spareknobs/Eris/pcb/Eris_v_1_1_pcb_render_front.png

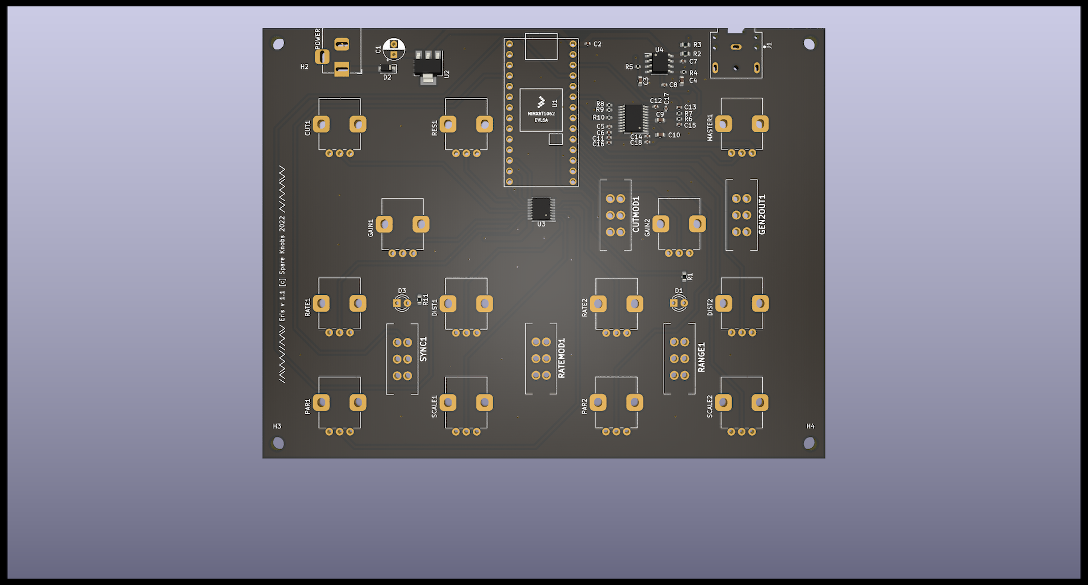
pcb/Eris_v_1_1_pcb_render_front.png
