spareknobs/Eris/Eris_v_1_1_Schematic.pdf

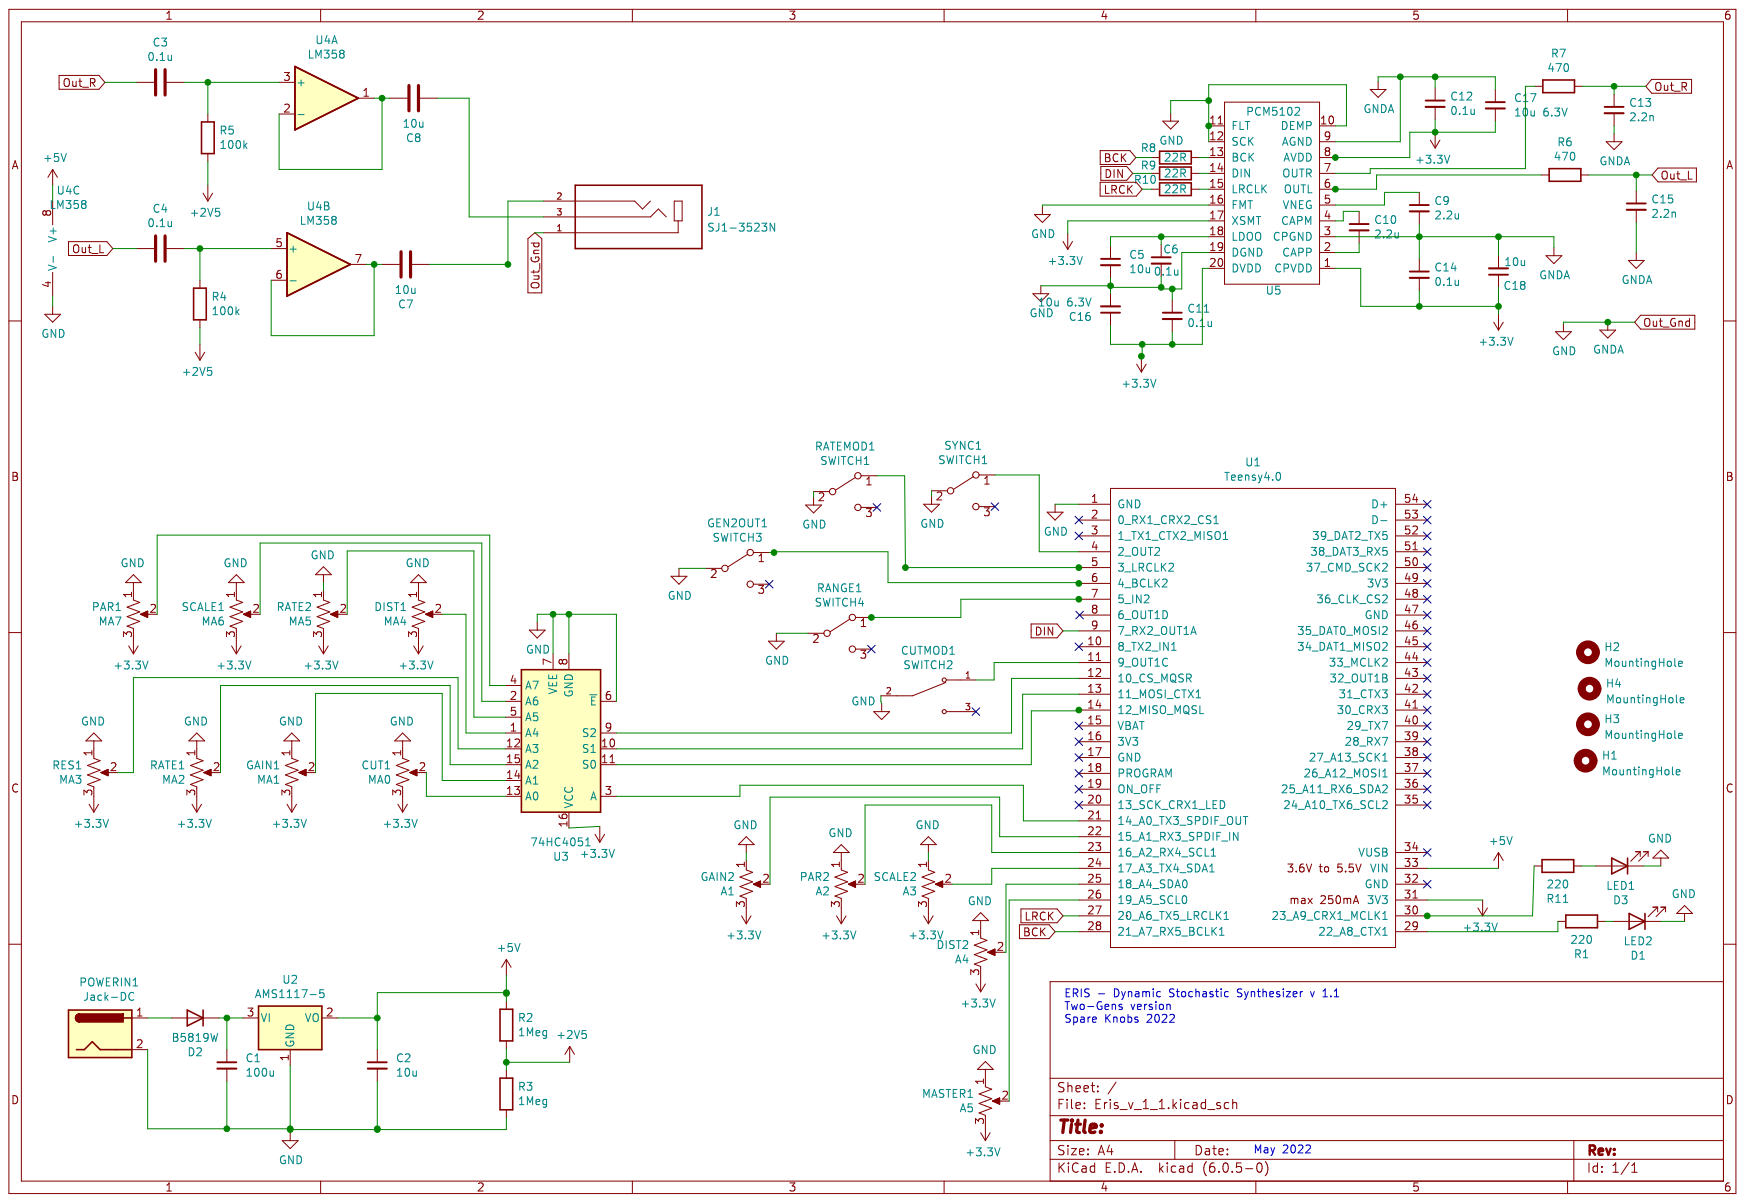
[picture p3: page 1]
