spareknobs/Eris/src/Eris.cpp

/*
   Eris - Dynamic Stochastic Synthesizer
   Spare Knobs 2020-2024

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
   You should have received a copy of the GNU General Public License
   along with this program; if not, write to the Free Software
   Foundation, Inc., 51 Franklin Street, Fifth Floor, Boston, MA 02110-1301  USA
*/

#include <Arduino.h>
#include "Eris.h"

Eris::Eris() : AudioStream( 0, NULL ){
   mGen1.SetSamplerate(SR_DEF);
   mGen2.SetFreqRange(0);
   mGen1.SetFreqNorm(0.25f);
   mGen1.SetScale(0.5f);
   mGen1.SetParam(0.5f);
   mGen2.SetSamplerate(SR_DEF);
   mGen2.SetFreqRange(0);
   mGen2.SetFreqNorm(0.5f);
   mGen2.SetParam(1.f);
   mGen2.SetScale(1.f);
   mGen2.SetDist(0.f);
   mVcf.SetCutoff(5000.f);
   mVcf.SetResonance(1.f);
   mVcf.octaveControl(0.f);
   mAREnv.SetGain(1.f);
   mAREnv.SetAttackMs(100.f);
   mAREnv.SetReleaseMs(200.f);
   msine.set_freq(400);
}

 void Eris::update(void){

   float blockGen1[AUDIO_BLOCK_SAMPLES];
   int16_t blockGen1t[AUDIO_BLOCK_SAMPLES];
   float blockGen2[AUDIO_BLOCK_SAMPLES];
   int16_t blockGen2t[AUDIO_BLOCK_SAMPLES];
   float blockLfo[AUDIO_BLOCK_SAMPLES];
   int16_t blockLfot[AUDIO_BLOCK_SAMPLES];

   audio_block_t *blockout;
   blockout = allocate();
   if (!blockout) return; 

   memset(blockGen1, 0, AUDIO_BLOCK_SAMPLES * sizeof(float));
   memset(blockGen2, 0, AUDIO_BLOCK_SAMPLES * sizeof(float));
   memset(blockGen1t, 0, AUDIO_BLOCK_SAMPLES * sizeof(int16_t));
   memset(blockGen2t, 0, AUDIO_BLOCK_SAMPLES * sizeof(int16_t));
   memset(blockLfot, 0, AUDIO_BLOCK_SAMPLES * sizeof(int16_t));
   memset(blockLfo, 0, AUDIO_BLOCK_SAMPLES * sizeof(float));

   // test
   //msine.Process(blockGen1, AUDIO_BLOCK_SAMPLES);

   mGen2.Process( blockGen2, blockGen2, 0.f, AUDIO_BLOCK_SAMPLES );   
         
   f2fix(blockGen2, blockGen2t, AUDIO_BLOCK_SAMPLES);

   // Update Gen2 Gain
   int16_t *op2 = (int16_t*)blockGen2t; 
   const int16_t* oend2 = (int16_t*)(blockGen2t + AUDIO_BLOCK_SAMPLES);
   do {
         if ( mGen2Gain < mGen2Gain_req ){
            mGen2Gain += GAIN_RAMP_STEP;
            if ( mGen2Gain > mGen2Gain_req )  mGen2Gain = mGen2Gain_req; 
         }
         else if ( mGen2Gain > mGen2Gain_req ){
            mGen2Gain -= GAIN_RAMP_STEP;
            if ( mGen2Gain < mGen2Gain_req )  mGen2Gain = mGen2Gain_req; 
         }
        int16_t tmp = *op2;
        *op2++ = ( mGen2Gain * tmp ) >> 16;
   } while (op2 < oend2);

   // Gen2 --> Lfo
   for ( int n=0; n < AUDIO_BLOCK_SAMPLES; ++n ) {
      float val =  (float)blockGen2t[n] * Q_DIV_16;
      //val = 0.5 * val + 0.5; 
      blockLfo[n] = val * 3.0; // scale up 
   }

   // Modulate Gen1 Rate with Lfo
   float vRateMod = (float)mRateMod;
   mGen1.Process( blockGen1, blockLfo, vRateMod, AUDIO_BLOCK_SAMPLES );
   f2fix(blockGen1, blockGen1t, AUDIO_BLOCK_SAMPLES);

   // Gen1 Gain @ sr
   int16_t *op1 = (int16_t*)blockGen1t; 
   const int16_t* oend1 = (int16_t*)(blockGen1t + AUDIO_BLOCK_SAMPLES);
   do {
         if ( mGen1Gain < mGen1Gain_req ){
            mGen1Gain += GAIN_RAMP_STEP;
            if ( mGen1Gain > mGen1Gain_req )  mGen1Gain = mGen1Gain_req; 
         }
         else if ( mGen1Gain > mGen1Gain_req ){
            mGen1Gain -= GAIN_RAMP_STEP;
            if ( mGen1Gain < mGen1Gain_req )  mGen1Gain = mGen1Gain_req; 
         }
        int16_t tmp = *op1;
        *op1++ = ( mGen1Gain * tmp ) >> 16;
   } while (op1 < oend1);
   
   // save a value for controlling LEDs
   mLastGen1Val = blockGen1[0] * blockGen1[0];
   mLastGen2Val = blockGen2[0] * blockGen2[0];
   
   if (mGen2ToOut){
      for ( int n=0; n < AUDIO_BLOCK_SAMPLES; ++n ) {
         int16_t vmix = signed_add_16_and_16(blockGen1t[n],blockGen2t[n]);
         blockGen1t[n] = vmix;
      }
   }

   // temp
   f2fix(blockLfo, blockLfot, AUDIO_BLOCK_SAMPLES);

   // Process Filter 
   mVcf.Process( blockGen1t, blockout->data, blockLfot, AUDIO_BLOCK_SAMPLES );

   // Process AR
   mAREnv.Process( blockout, AUDIO_BLOCK_SAMPLES );
   if (mAREnv.Done()) mMidiFreq_req=0;

   // (double mono for now)
   transmit( blockout,0 );
   transmit( blockout,1 );   
   release( blockout );
 }

void Eris::TriggerMidiNote( byte acNote, byte acVel ){
      __disable_irq();
      mMidiFreq_req = gcNoteFreqs[acNote];
      mGen1.SetFreq(mMidiFreq_req);
      
      // control gen2 only if @audiorate
      if ( mGen2Range==0 ){
         int ind = (int)round( mGen2Rate_req * (NPARTIALRATIOS-1) );
         float vpartialRatio = gcPartialsRatios[ind];
         float vval = Clip( vpartialRatio * mGen1.Freq(), FREQ_MIN, FREQ_MAX );
         mGen2.SetFreq( vval );
      }  
      mAREnv.SetGain( (float)acVel * DIV127 );
      mAREnv.TriggerAttack();
      __enable_irq();
    }

void Eris::TriggerRelease(){
      __disable_irq();
      mAREnv.TriggerRelease();
      __enable_irq();
   }

void Eris::SetGen1Rate( float acValue ){
   __disable_irq();
   // if midi note active, bypass
   if (mMidiFreq_req == 0){
      mGen1Rate_req = acValue;
      mGen1.SetFreqNorm(mGen1Rate_req);
   }
   // if midi note active and gen2 is @ audiorate, or sync is on, gen2 rate controls the harmonic #
   if ( mSyncGens==true || ( mMidiFreq_req>0 && mGen2Range==0 )){
      int ind = (int)round( mGen2Rate_req * (NPARTIALRATIOS-1) );
      float vpartialRatio = gcPartialsRatios[ind];
      float vval = Clip( vpartialRatio * mGen1.Freq(), FREQ_MIN, FREQ_MAX );
      mGen2.SetFreq( vval );
   }      
   __enable_irq();
}

void Eris::SetGen2Rate( float acValue ){      
   __disable_irq();
   mGen2Rate_req = acValue;
   // if midi note active and gen2 is @ audiorate, or sync is on, gen2 rate controls the harmonic #
   if ( mSyncGens==true || ( mMidiFreq_req>0 && mGen2Range==0 )){
      int ind = (int)round( mGen2Rate_req * (NPARTIALRATIOS-1) );
      float vpartialRatio = gcPartialsRatios[ind];
      float vval = Clip( vpartialRatio * mGen1.Freq(), FREQ_MIN, FREQ_MAX );
      mGen2.SetFreq( vval );
   }
   else{
      mGen2.SetFreqNorm( mGen2Rate_req );
   }
   __enable_irq();
}
