spareknobs/Eris/include/VCFixed.h

/*
   Eris - Dynamic Stochastic Synthesizer
   Spare Knobs 2020-2024

  State Variable Filter (Chamberlin) with 2X oversampling

  Adapted from the implementation by Paul Stoffregen, see:
  https://github.com/PaulStoffregen/Audio
 
  */

/* Audio Library for Teensy 3.X
 * Copyright (c) 2014, Paul Stoffregen, paul@pjrc.com
 *
 * Development of this audio library was funded by PJRC.COM, LLC by sales of
 * Teensy and Audio Adaptor boards.  Please support PJRC's efforts to develop
 * open source software by purchasing Teensy or other PJRC products.
 *
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
 * THE SOFTWARE IS PROVIDED "AS IS", WITHOUT WARRANTY OF ANY KIND, EXPRESS OR
 * IMPLIED, INCLUDING BUT NOT LIMITED TO THE WARRANTIES OF MERCHANTABILITY,
 * FITNESS FOR A PARTICULAR PURPOSE AND NONINFRINGEMENT. IN NO EVENT SHALL THE
 * AUTHORS OR COPYRIGHT HOLDERS BE LIABLE FOR ANY CLAIM, DAMAGES OR OTHER
 * LIABILITY, WHETHER IN AN ACTION OF CONTRACT, TORT OR OTHERWISE, ARISING FROM,
 * OUT OF OR IN CONNECTION WITH THE SOFTWARE OR THE USE OR OTHER DEALINGS IN
 * THE SOFTWARE.
 */

#pragma once

#include <Arduino.h>    
#include "AudioStream.h"

class VCFixed
{
public:
	VCFixed() {
		SetCutoff(1000);
		octaveControl(1.0); // default values
		SetResonance(0.707);
		state_inputprev = 0;
		state_lowpass = 0;
		state_bandpass = 0;
	}

    void Process(const int16_t *in,  int16_t *out, const int16_t *ctl,  const int acsamples );
	
	void SetCutoff(float freq) {
		if (freq < 20.0f) freq = 20.0f;
		else if (freq > AUDIO_SAMPLE_RATE_EXACT/2.5f) freq = AUDIO_SAMPLE_RATE_EXACT/2.5f;
		setting_fcenter = (freq * (3.141592654f/(AUDIO_SAMPLE_RATE_EXACT*2.0f)))
			* 2147483647.0f;
		// TODO: should we use an approximation when freq is not a const,
		// so the sinf() function isn't linked?
		setting_fmult = sinf(freq * (3.141592654f/(AUDIO_SAMPLE_RATE_EXACT*2.0f)))
			* 2147483647.0f;
	}
	void SetResonance(float q) {
		if (q < 0.7f) q = 0.7f;
		else if (q > 5.0f) q = 5.0f;
		// TODO: allow lower Q when frequency is lower
		setting_damp = (1.0f / q) * 1073741824.0f;
	}
	void octaveControl(float n) {
		// filter's corner frequency is Fcenter * 2^(control * N)
		// where "control" ranges from -1.0 to +1.0
		// and "N" allows the frequency to change from 0 to 7 octaves
		if (n < 0.0f) n = 0.0f;
		else if (n > 6.9999f) n = 6.9999f;
		setting_octavemult = n * 4096.0f;
	}
	
private:
	int32_t setting_fcenter;
	int32_t setting_fmult;
	int32_t setting_octavemult;
	int32_t setting_damp;
	int32_t state_inputprev;
	int32_t state_lowpass;
	int32_t state_bandpass;
};
