spareknobs/Eris/(commit log)

2024-03-30 added pcb files and schematic
    [Eris_v_1_1_BOM.csv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]
2024-07-05 update bias gain, fixp
    [AREnv.cpp, AREnv.h, Eris.cpp, Eris.h, Main.cpp]
2024-07-05 added VCF fixp vers, many fixes, midi
    [AREnv.cpp, AREnv.h, Eris.cpp, Eris.h, GenDyn.cpp, GenDyn.h, Main.cpp, VCFixed.cpp]
